brodoluca/3th_Sem_Prototype/Documentation/Front.jpg

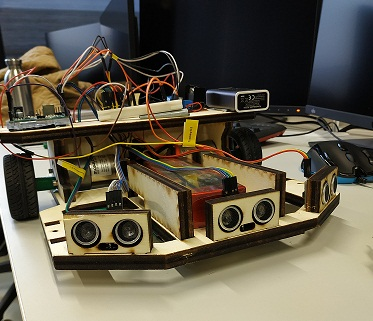
Documentation/Front.jpg
