brodoluca/3th_Sem_Prototype/Versions/Version1.1.rtf

****VERSION NOT TESTED YET *****

This version differentiate from the other from some adjustments we made.
First of all, the function responsible for the line tracking works with a while loop instead of if statements. This allows the bot to intercept the line and follow the trajectory.
We also implement another function in case the bot intercept a line but both sensor detect black
