brodoluca/3th_Sem_Prototype/Versions/Sequence_diagram.pdf

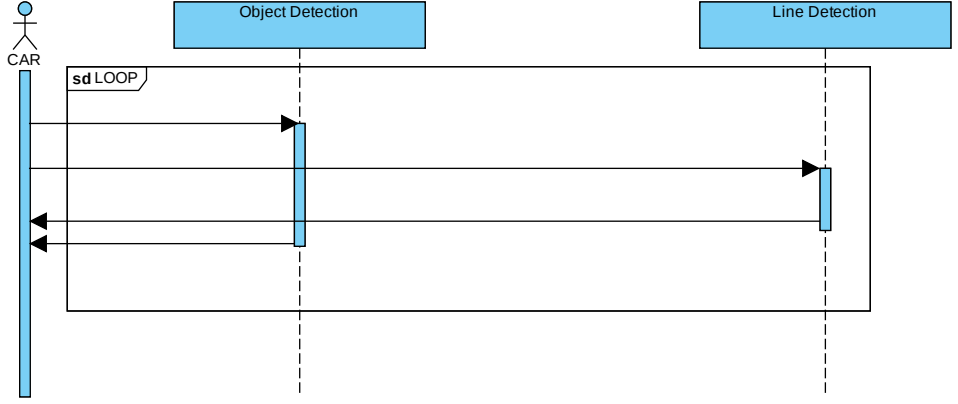
[picture p27: figure]
bject; ectio; Lin
