brodoluca/3th_Sem_Prototype/Documentation/Back.jpg

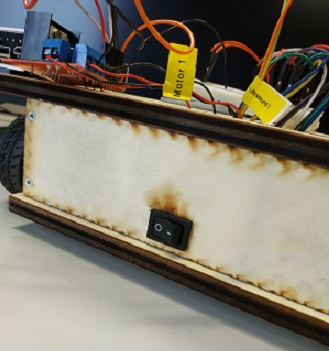
Documentation/Back.jpg
