brodoluca/3th_Sem_Prototype/Documentation/Car battery.jpg

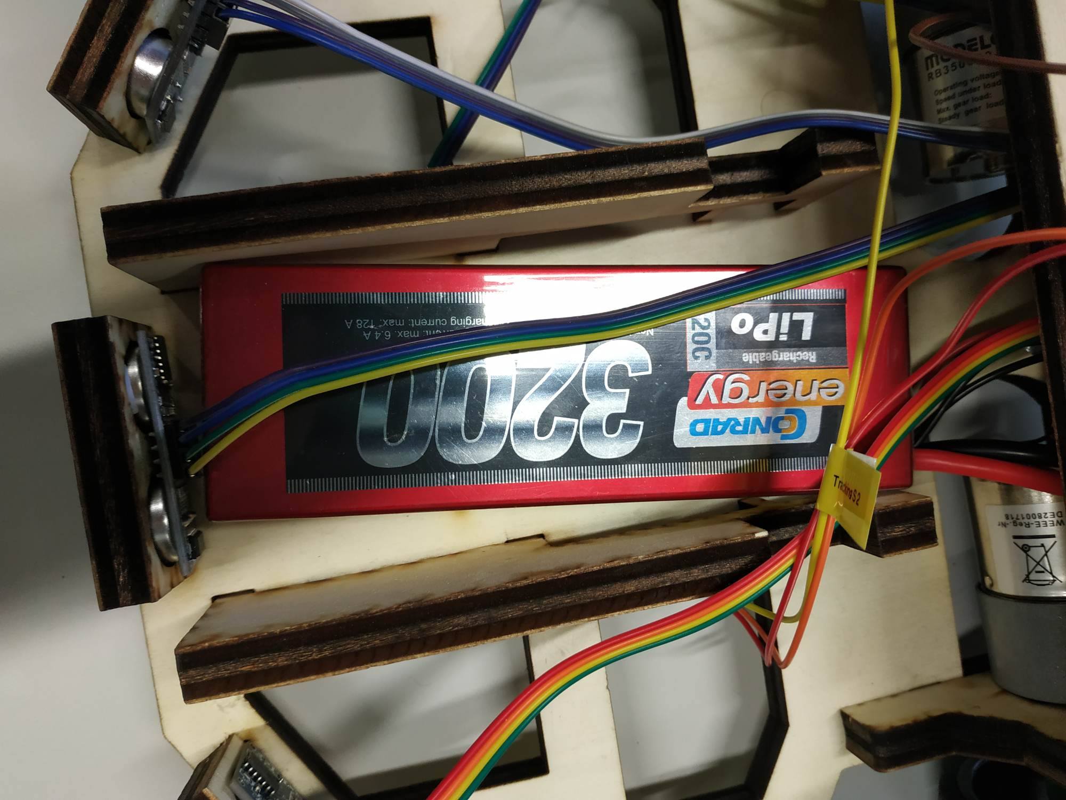
Documentation/Car battery.jpg
