brodoluca/3th_Sem_Prototype/Documentation/Qt Interface.jpg

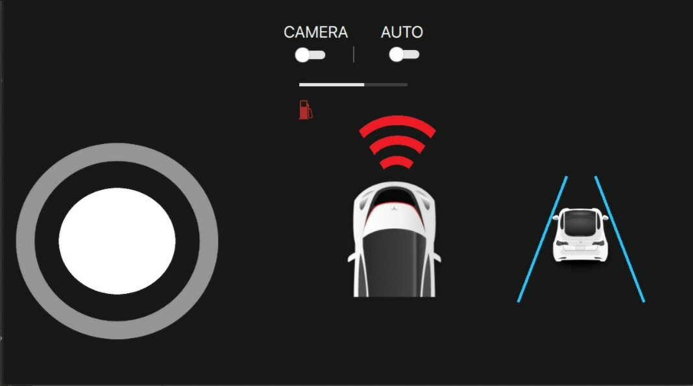
Documentation/Qt Interface.jpg
