brodoluca/3th_Sem_Prototype/Documentation/State machine diagram.jpg

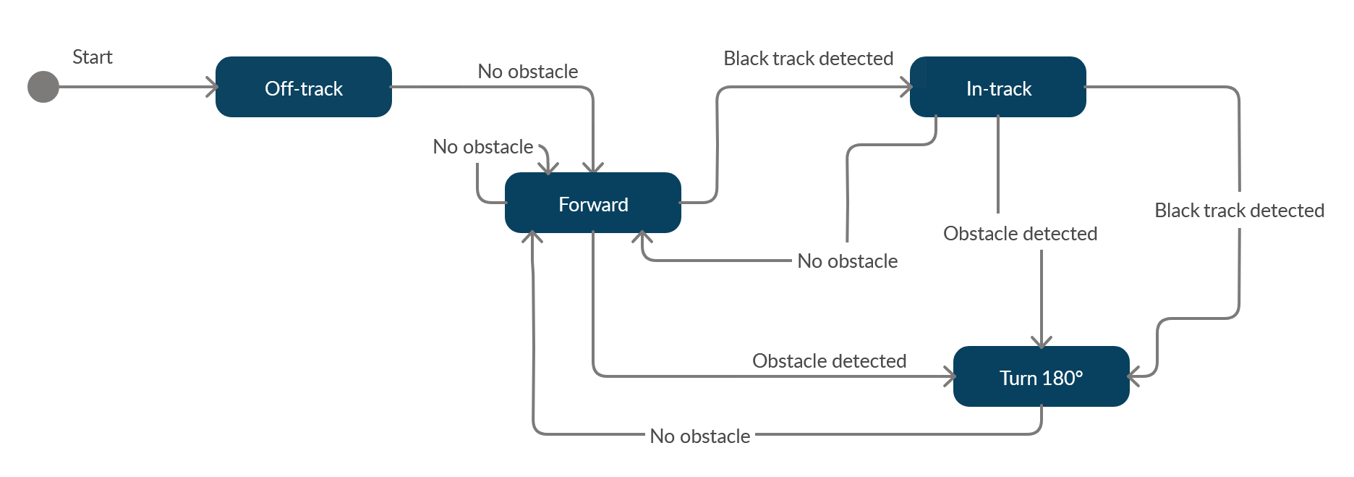
Documentation/State machine diagram.jpg
