brodoluca/3th_Sem_Prototype/Documentation/Motor_Activity_Diagram.pdf

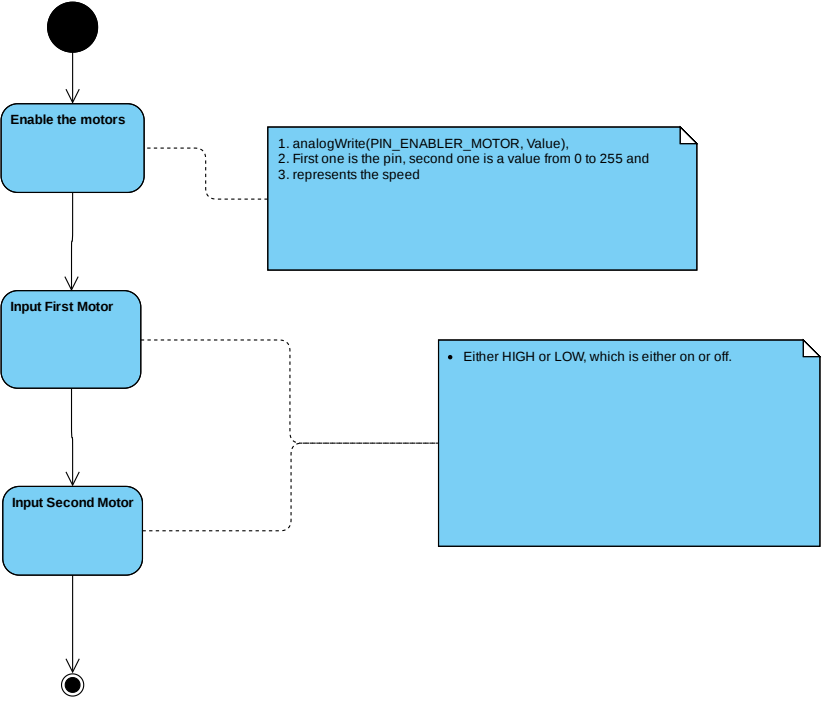
[picture p35: page 1]

Enable the motors

1. analogWrite(PIN_ENABLER_MOTOR, Value),
2. First one is the pin, second one is a value from 0 to 255 and
3. represents the speed

Input First Motor

Either HIGH or LOW, which is either on or off.

Input Second Motor
