brodoluca/3th_Sem_Prototype/Documentation/Machine_Object_Detection.pdf

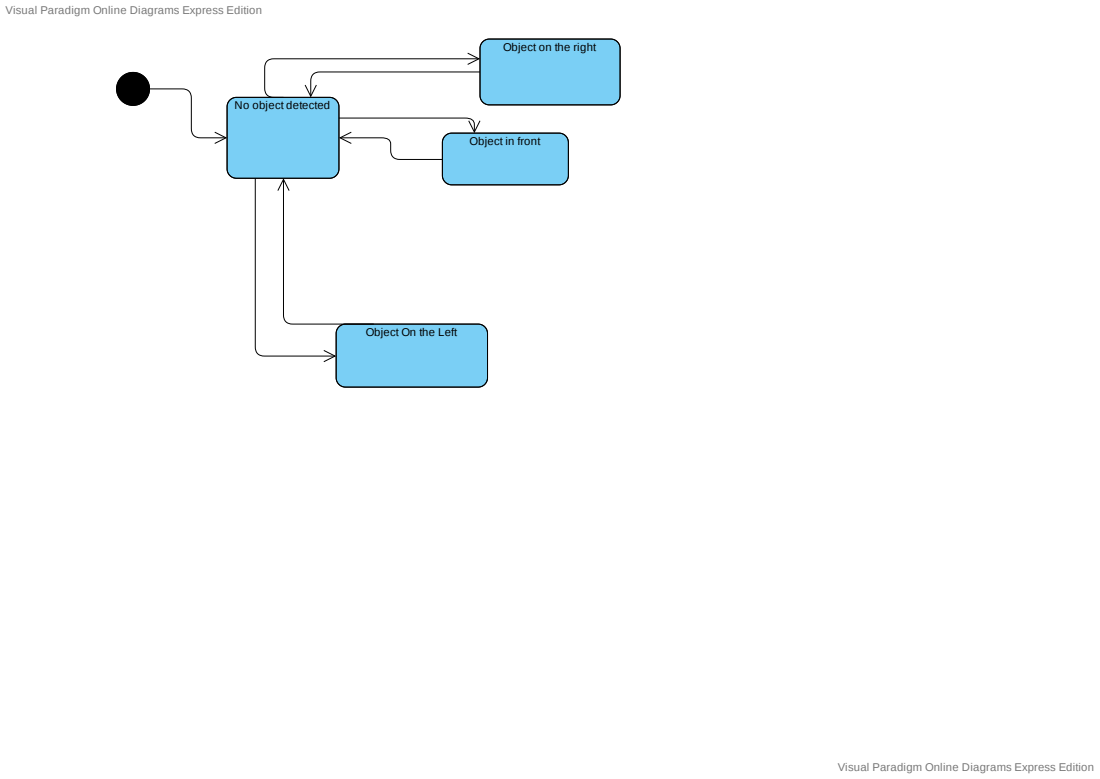
[picture p36: page 1]

Visual Paradigm Online Diagrams Express Edition

Object on the right

No object detected

Object in front

Object On the Left
