brodoluca/3th_Sem_Prototype/(commit log)

2019-11-30 Create Motor Functions.ino
2019-11-30 Update Motor Functions.ino
    Original functions for the motors.
2019-11-30 Rename Motor Functions.ino to MotorFunctions_v0_Bluetooth.ino
