brodoluca/3th_Sem_Prototype/Documentation/First-Interface.jpg

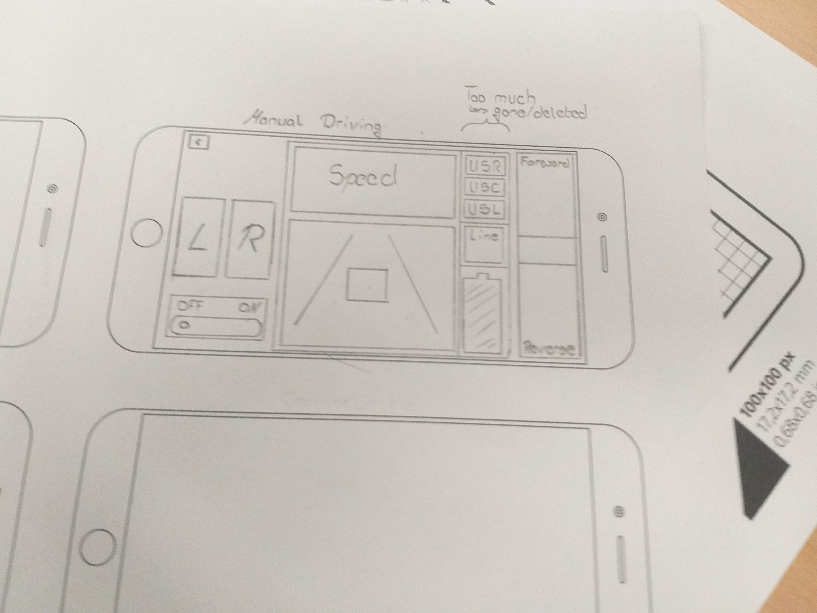
Documentation/First-Interface.jpg
